fern996/CS207_TeamProject/img/Back.jpeg

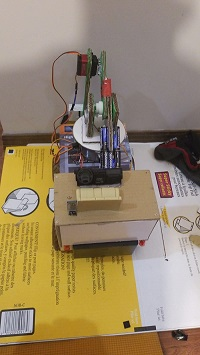
img/Back.jpeg
