fern996/CS207_TeamProject/img/front.jpeg

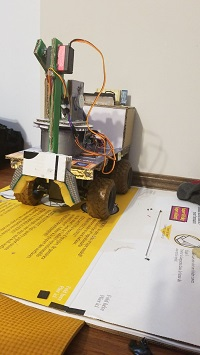
img/front.jpeg
