fern996/CS207_TeamProject/img/shoulder.png

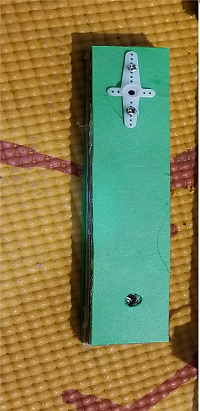
img/shoulder.png
