fern996/CS207_TeamProject/img/Top.jpeg

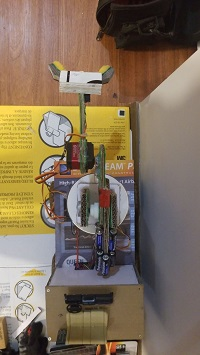
img/Top.jpeg
