fern996/CS207_TeamProject/(commit log)

2018-11-09 updating the Requirements and Materials
    line 21 to 53
2018-12-11 uploading stepper library
